WangXuan95/FPGA-FOC/(threads)

Thread 1 (2021-03-01):

求RTL文件下对应每个模块的modelsim仿真测试代码！

red1508, 2021-03-01:
作者您好！ 能加个联系方式吗？很紧急，需要modelsim仿真测试代码，请问您有仿真代码吗？谢谢！

red1508, 2021-03-01:
急需仿真测试代码！ 方便的话能加个联系方式吗？我微信： lpf360726

WangXuan95, 2021-03-01:
你好，我没有对该工程进行整体仿真，因为仿真法很难模拟出电机的行为。但是为了验证正确性，我分模块单独进行了一些仿真，一些复杂的模块我用 SystemVerilog 写了 testbench （我没有把testbench挂在github上），简单的模块我就没写 testbench ，因为能保证肯定没问题。你可以阅读每个模块的定义来自己写 testbench 进行验证（因为输入输出都不复杂，所以 testbench 写起来非常简单）。我已加你微信。

xiao162, 2021-05-20:
作者您好！想向你请教关于fpga控制电机方面的知识，可以加个微信吗，微信号18297670446

user855, 2021-05-31:
作者您好!我有个问题想问您，第一，相电流低压侧三电阻采样需要运放放大电流信号才能作为AD输入吧，但您的PCB图并没有运放放大，请问您是如何处理的？ 第二，三电阻采样您电流重构的那部分代码如何理解呢？为什么ia= ADCb + ADCc - 2*ADCa。方便的话可以加个联系方式嘛？微信号：ZYH336614215。期待您的回复！

Closed 2022-04-07.

Thread 2 (2021-05-31):

关于电机FOC控制的一些疑惑

user855, 2021-05-31:
作者您好!我有个问题想问您，第一，相电流低压侧三电阻采样需要运放放大电流信号才能作为AD输入吧，但您的PCB图并没有运放放大，请问您是如何处理的？ 第二，三电阻采样您电流重构的那部分代码如何理解呢？为什么ia= ADCb + ADCc - 2*ADCa。方便的话可以加个联系方式嘛？微信号：ZYH336614215。期待您的回复！

WangXuan95, 2021-06-02:
你好！

第一，[我的PCB](https://oshwhub.com/wangxuan/arduino-foc-shield)使用了一体化的三相无刷电机驱动芯片MP6540（U1），3相电流采样电阻和放大器是集成在里面的。请注意MP6540的 SOA, SOB, SOC 三个引脚，它们就是三相电流放大后的电流输出。

第二，说来话长，我们知道电机的相电流 ia, ib, ic 是双极性的（即有正有负的，分别代表流出电机和流入电机），但我们常用的ADC往往都是单极性的（即只能采样正电压）。那么，相电流采样-放大电路就必须考虑双极性到单极性的转换问题，工程上用的方法往往都是反向放大加偏置（包括MP6540内置采样-放大电路也是这种方案），它输出给ADC的电压遵循公式：
ADCa = -R * ia + Voff
ADCb = -R * ib + Voff
ADCc = -R * ic + Voff
其中 R 是放大系数（R>0，也叫跨阻放大系数，因为 R 的量纲和电阻一样），因为反向放大所以加了负号。Voff 是偏置电压，以此保证 ADCa, ADCb, ADCc 是单极性的。
另外又有基尔霍夫电流定律（KCL）：
ia + ib + ic = 0
联立以上公式，可以推出：
3 * Voff = ADCa + ADCb + ADCc
我们令 R = 1/(3*k) ，于是：
ia = (Voff - ADCa) / R
    = k * (3 * Voff - 3 * ADCa)
    = k * (ADCa + ADCb + ADCc - 3 * ADCa)
    = k * (ADCb + ADCc - 2*ADCa)

于是就有了你问的  ia= ADCb + ADCc - 2*ADCa

你肯定会问，系数k哪儿去了？这个我们并不在乎，因为整个FOC都是线性系统，通过调整PID参数，能跑就行，系数只在理论分析时有用。

WangXuan95, 2021-06-02:
你好！

第一，[我的PCB](https://oshwhub.com/wangxuan/arduino-foc-shield)使用了一体化的三相无刷电机驱动芯片MP6540（U1），3相电流采样电阻和放大器是集成在里面的。请注意MP6540的 SOA, SOB, SOC 三个引脚，它们就是三相电流放大后的电流输出。

第二，说来话长，我们知道电机的相电流 ia, ib, ic 是双极性的（即有正有负的，分别代表流出电机和流入电机），但我们常用的ADC往往都是单极性的（即只能采样正电压）。那么，相电流采样-放大电路就必须考虑双极性到单极性的转换问题，工程上用的方法往往都是反向放大加偏置（包括MP6540内置采样-放大电路也是这种方案），它输出给ADC的电压遵循公式：
ADCa = -R * ia + Voff
ADCb = -R * ib + Voff
ADCc = -R * ic + Voff
其中 R 是放大系数（R>0，也叫跨阻放大系数，因为 R 的量纲和电阻一样），因为反向放大所以加了负号。Voff 是偏置电压，以此保证 ADCa, ADCb, ADCc 是单极性的。
另外又有基尔霍夫电流定律（KCL）：
ia + ib + ic = 0
联立以上公式，可以推出：
3 * Voff = ADCa + ADCb + ADCc
我们令 R = 1/(3*k) ，于是：
ia = (Voff - ADCa) / R
    = k * (3 * Voff - 3 * ADCa)
    = k * (ADCa + ADCb + ADCc - 3 * ADCa)
    = k * (ADCb + ADCc - 2*ADCa)

于是就有了你问的  ia= ADCb + ADCc - 2*ADCa

你肯定会问，系数k哪儿去了？这个我们并不在乎，因为整个FOC都是线性系统，通过调整PID参数，能跑就行，系数只在理论分析时有用。

user855, 2021-06-04:
谢谢您的回复！但我仍还有一些问题想请教一下您。

 针对问题一，我对AD采样部分我还有部分疑惑，您用的AD7928只有一个T/H(采样保持器)，也就意味着这个AD一次只能保持一个通道的数据，也就是说当通道1 打开的时候采集A相的电流，然后采集完再打开通道2采集B相的电流，那么这并不是一个同步采集的过程，您是如何实现AD采样三相电流的同步输出的呢？

针对问题二，我想知道您的程序里是不是都没有在乎系数K，包括clake变换中得到的i_alpha和i_beta和ia、ib、ic也并没有满足严格的公式关系，您程序中得到的i_alpha和i_beta是理论值的2倍。这是不是也可以用调整PID参数的思想来解释？

问题三，您有没有推荐的verilog深入学习的书籍推荐，我看到您程序中的一些设计方法很好，很想深入系统的学习一下，不知道您有没有什么资料推荐？
期待您的回复^_^

WangXuan95, 2021-06-06:
**回答问题1**：
在电流采样问题上，FpOC 与大多数 FOC 方案相同，因为 MP6540 里的采样电阻在下桥臂，所以规定 SVPWM 在每个控制周期（约 55us，对应频率18kHz）内至少有一段时间里 3 相都是下通上闭，称为**采样窗口**。FOC的基础振幅（也就是 foc_top.sv 里的 **MAX_AMP** 参数）越大，**采样窗口**越短。当 **MAX_AMP**=9'd511 (最大值) 时，**采样窗口**长度就是 0 了。而默认的 **MAX_AMP**=9'd384 大概会让**采样窗口**长度为十几us。
**AD7928** 只有一个T/H，所以**采样窗口**内要做 3 次采样，这个过程是 **hold_detect.sv** 和 **adc_ad7928.sv** 共同控制的，**hold_detect.sv**负责在采样窗口开始时延迟一段时间（来让电流趋于稳定）后发出 **sn_adc** 信号脉冲，来告诉 **adc_ad7928.sv** 可以开始工作了（可以通过 foc_top.sv 里的 SAMPLE_DELAY 来调整该延迟）。然后 **adc_ad7928.sv** 内部就会自动串行地完成 3 个通道的采样，最后再同步提交3个采样结果（提交的同时产生 **o_en_adc** 信号脉冲）。注意**adc_ad7928.sv**是一个通用的 **AD7928** 控制器，每收到一个  **i_sn_adc** 信号脉冲，就进行一系列串行采样。其中采样多少次，每次采样哪一个通道，都可以通过 **adc_ad7928.sv** 里的 parameter 来配置。所有通道采样结束后，产生**o_en_adc**信号脉冲，同时同步提交所有通道的结果。
我把 **foc_top.sv** 用来连接 ADC控制器的接口（也就是sn_adc, en_adc, adc_a, adc_b, adc_c 这几个信号）设计成同步读入3通道数据，是出于**通用性**、**简约性**和**可移植性**的原则考虑，因为这样的同步读入接口是 ADC 的一种高度抽象，最容易让人理解其时序（即，**sn_adc**脉冲命令ADC控制器开始工作。**en_adc**指示ADC读取器结束工作，同时 adc_a, adc_b, adc_c 上产生结果）。如果用户用了其它 ADC 型号，只需按照这个时序的抽象来具象地编写 ADC 控制器即可，而 **foc_top.sv** 并不关心拟用的是1个串行的ADC还是3个并行的ADC，反正你都要给我同步提交。当然，用户必须自己算好 **hold_detect.sv** 的延时 + ADC 采样三个通道（也即 **sn_adc** 脉冲和 **en_adc** 脉冲的时间差） 是小于 **采样窗口** 的长度的。

WangXuan95, 2021-06-06:
**回答问题2**：
是的，我很多地方的代码也与理论公式的系数不同，比如 clark 变换公式本来是：
- Iα = Ia - Ib/2 - Ic/2
- Iβ = √3/2 * (Ib - Ic)

我多乘了个2：

- Iα = 2 * Ia - Ib - Ic
- Iβ = √3 * (Ib - Ic)

这是出于避免整数计算的截断导致的数据位丢失，比如 Ib/2 就会让 Ib 的最低 bit 丢失。不过实际上这种小误差丝毫不会影响控制质量。
这种系数问题可以通过 PID 调参来消除。

实际上如果是成熟的控制器，应该出个文档，简明地给出整个过程中所有的运算叠乘起来的系数 k，用户可能关心这个k，因为很多FOC实际上是用理论分析（也就是把电机参数代入电机方程）来整定 PID 参数的。我是搞FPGA的，控制方面是门外汉，做这个东西是为了玩，所以没出这个文档说明，而且我自己调电机时是试出来的 PID 参数（手动狗头）

WangXuan95, 2021-06-06:
**回答问题3**：除了学 Verilog 基础语法外，我就没看过书了，所以也给你推荐不来。很多我都是自己写着写着发现的，比如发现怎样分模块抽象度更高，复用性更好，那我以后都这么写。

不知道你是初学还是进阶，学基础语法你可以看书（这种书很多，就不用我推荐了吧），同时可以上 [HDLBits](https://hdlbits.01xz.net/wiki/Main_Page) 做题（这里面题都很基础），同时为了不脱离实际，还要自己写小东西，比如做串口、SPI等芯片的控制把芯片驱动起来，这样才能达到最好的入门效果。

进阶的话，实际上硬件设计和优化是有很多技巧和定式（比如握手、流水、双缓冲、分支预测、脉动阵列之类），这方面我好像真没看见过什么书或者有谁总结过，可能是我孤陋寡闻了，如果能搜到这类技巧的总结来看，是能事倍功半的。不过有一点我很确定——进阶是要靠多写的，比如写复杂接口（比如 AXI4，SDR-SDRAM，以太网，SDIO，CAN 等）；复杂算法（电机控制、图像处理等）；写个CPU也是很好的选择。

user855, 2021-06-08:
谢谢您的回复！ 您的指导让我受益匪浅。 原谅我又有新问题了。
问题1，您进行串行采样的时候不会出现这样的问题嘛，即第一个时钟周期采到的是A相的电流，第2个时钟周期采的是B相，第3个时钟周期采到的是C相，而我们知道相电流是正弦变化的，这三个时钟周期采的A B C 三相电流并不是同一时刻的相电流，因此这将产生误差，而时钟周期是很短的，是不是产生的误差几乎可以忽略不计呢？
问题2，我想知道您的时钟频率为什么选择36.864MHz？这个时钟频率是有什么特殊含义嘛？我如果选择FPGA的50MHz会出现什么问题呢？
问题3，您的控制频率= 时钟频率 / 2048，为什么控制频率 = 时钟频率 / 2048？ 我觉得控制频率和时钟频率应该是没有必然的联系的吧，时钟频率是FPGA的时钟频率，而控制频率是pwm的频率，一般是几十khz，所以您是根据控制频率来确定的时钟频率嘛？

WangXuan95, 2021-06-11:
回答问题1，首先指正一个不准确的地方， **AD7928** 的接口是 SPI （一种串行接口），其采样是多个时钟周期（而不是一个时钟周期）内完成的。因此三相的采样间隔是几十个时钟周期（具体数字我忘了，你可以仿真确定一下）。虽然并不同步，但3相的采样毕竟都是在同一个控制周期的采样窗口（几微秒）内，而相电流的变化通常以控制周期（即几十微秒）为尺度变化，想想3000r/min（50r/s）的转子，若极对数=7，其相电流也不过是350Hz（周期28ms）的正弦波，该正弦波在几微秒内的变化是可以忽略的。

回答问题2，其实选 36.864MHz，只是因为可以让控制周期为 36864/2048 = 18kHz，凑个整。
foc_top.sv 和 as5600_read.sv 对时钟频率是没有要求的，多高都可以（唯一的限制是频率太高时序不收敛）
但 adc_ad7928.sv 限制了频率不能大于 40.96MHz，因为 ADC7928 的 SPI 时钟不能超过 20.48MHz，而 adc_ad7928.sv 内部用驱动时钟2分频作为SPI时钟。
综上，时钟频率是可调的，但要小于 40.96MHz。

回答问题3， 理想地来讲，FPGA时钟频率和控制周期确实没有关系，但要考虑实际啊，PWM不也是FPGA的时钟驱动的？既然如此，必然有个分频系数（控制频率 = 时钟频率 / 分频系数），别的驱动器可能具有可调的分频系数，但FpOC里为了简单，分频系数=2048。这意味着 FpOC 如果要调节控制频率，就只能调时钟频率，目前受限于上述ADC7928的频率限制，最高的控制频率是 40.96MHz/2048=20kHz。

user855, 2021-06-16:
谢谢您的回答。您的指导让我受益匪浅^ ^  然而我又有新问题了...
问题一，我看您的pi那部分代码是位置式pi控制， 其计算的表达式是$$_u_k = K_p(e_k)+K_i\sum(e_k)_$$，根据计算公式，您代码中的参量kpidelta即应该为输出结果，您pi_controller.sv代码中的91-100行的always块中的  value <= protect_add(value, kpidelta); 这一步是什么原理？位置式的pi又为何要求每一步的增量呢？以及您的pi并未设置积分限幅和积分清零，是否有必要设置呢？

问题二，您代码中的cartesian2polar,sv是把电压矢量从转子直角坐标系 (Vd, Vq) 变换到转子极坐标系 (Vrρ, Vrθ)，我一直不理解我们为什么要变换到转子极坐标系中进行运算？是为了简化计算亦或是处于其他目的？

jjinl, 2024-06-18:
你好，求教一下，svpwm.sv中 查表，输入和输出是什么关系？  x2--> y3
always @ (posedge clk)
case(x2)
10'd0:y3<=9'd442;
10'd1:y3<=9'd443;

Closed 2022-03-23.

Thread 3 (2021-08-26):

关于pid_control有点点疑问

clarekee, 2021-08-26:
pid_control里的赋值语句
assign o_value = value[31:16];
这里为什么需要除以2的16次方哈？
第二个疑问：您积分项计算采用了之前所有时刻累积的误差，也就是采用绝对PID控制的公式，但是输出的结果加在了上一时刻的输出结果，也就是代码默认的是增量式PID，但是增量式PID采用的是近三个周期的误差即可，感觉有点前后矛盾。

Closed 2023-06-09.

Thread 6 (2022-09-04):

关于phi数值放缩请教的问题

chenmengqi52421314, 2022-09-04:
在ipark处理完输出导SVPWM的模块中会有一个角度的输出，我在使用您的程序尝试进行控制BLDC时，由于我的编码器是1000脉冲，因此在输出的电角度时，我采用您的公式  psi <= {4'h0, POLE_PAIR} * (phi   - init_phi );  无法将电机转动，但我发现电机已经转动了180度，此时我将 输出改为 psi <= {4'h0, POLE_PAIR} * ((phi   - init_phi) << 2 );  这时，电机便能转动起来了；我想请教下，输出到SVPWM的电角度是否需要进行放缩处理；
 同时，我希望能和前辈沟通下相关的FPGA控制的内容，这是我的微信13692354659，希望前辈方便的状况下能指点下。

zxy180427, 2023-08-15:
您好，我在进行电流环闭环调试时，PID部分遇到一些问题，首先我看您最新修改了PID的公式，我先按照您原程序进行测试，首先我将VQ等于0，让ID跟随目标值进行变换，只使用P项进行调节，遍历后，依然没有得到想要的曲线

Thread 9 (2023-08-15):

关于PID调参的一些问题

zxy180427, 2023-08-15:
您好，我在进行电流环闭环调试时，PID部分遇到一些问题，首先我看您最新修改了PID的公式，我先按照您原程序（将最终结果值累加）进行测试，首先我将VQ等于0，让ID跟随目标值进行变换，只使用P项进行调节，遍历P值后，依然没有得到想要的曲线，我自己也编写了一个增量式的程序，结果也不尽人意，希望得到一些指点。

zxy180427, 2023-08-16:
且在开环调试时，我给定vd和vq值，经过堵转得到的IQ值为负数，经过电机换相后，情况并没有改观，您遇到过这个情况吗？

Thread 13 (2024-05-02):

Application without an ADC

jadoro, 2024-05-02:
Hi,

thank you very much for this great project!
I've been reading your notes on a minimal demo setup, where you list the ADC as one of the mandatory components. Can your control algorithm also be used without an ADC if torque control is not required?

Thanks a lot in advance!

WangXuan95, 2025-01-13:
Hello, this code must use ADC. The motor control method without ADC you mentioned is not FOC, at least not typical FOC. It cannot achieve torque control and has low efficiency. For its implementation, you can refer to SimpleFOC of Arduino: https://simplefoc.com/

Closed 2025-01-13.

Thread 14 (2024-07-01):

SVPWM仿真出来的波形和您给的图不太一样

a593765797, 2024-07-01:
您好您好，我根据您的代码进行仿真出来的SVPWM马鞍波部分和您给的图不太一样，请问给出的SVPWM部分的代码是最终版本吗？主要是我也没太懂您SVPWM代码的逻辑，不太清楚该咋改。想请教您一下这部分的思路，可以方便加个联系方式么？我的微信是15603329173，万分感谢！

WangXuan95, 2025-01-13:
不太可能。是不是你没缩放到位。截图看看波形？
