WangXuan95/FPGA-FOC/RTL/foc/svpwm.v

//--------------------------------------------------------------------------------------------------------
// 模块：svpwm
// Type    : synthesizable
// Standard: Verilog 2001 (IEEE1364-2001)
// 功能：7 段式 SVPWM 生成器（调制器） 
// 输入：定子极坐标系下的电压矢量 Vsρ, Vsθ
// 输出：PWM使能信号 pwm_en
//       3相PWM信号 pwm_a, pwm_b, pwm_c
// 说明：该模块产生的 PWM 的频率是 clk 频率 / 2048。例如 clk 为 36.864MHz ，则 PWM 的频率为 36.864MHz / 2048 = 18kHz
//--------------------------------------------------------------------------------------------------------

module svpwm (
    input  wire        rstn,
    input  wire        clk,
    input  wire [ 8:0] v_amp,                       // svpwm 的最大电压矢量的幅值
    input  wire [11:0] v_rho,                       // 定子极坐标系下的电压矢量的幅值 Vsρ
    input  wire [11:0] v_theta,                     // 定子极坐标系下的电压矢量的角度 Vsθ
    output reg         pwm_en, pwm_a, pwm_b, pwm_c  // PWM使能信号 pwm_en, 3相PWM信号 pwm_a, pwm_b, pwm_c
);

localparam ROM_LATENCY = 11'd4;

reg  [10:0] cnt;
reg  [11:0] rom_x;
reg         rom_sy;
reg  [ 8:0] rom_y;
reg  [ 8:0] mul_i1;
reg  [11:0] mul_i2;
wire [20:0] mul_y = mul_i1 * mul_i2;
reg  [11:0] mul_o;
reg         sya, syb, syc;
reg  [ 8:0] ya, yb;
reg  [ 9:0] pwma_duty, pwmb_duty, pwmc_duty;
reg  [10:0] pwma_lb, pwma_ub, pwmb_lb, pwmb_ub, pwmc_lb, pwmc_ub;
reg         pwm_act;

always @ (posedge clk or negedge rstn)
    if(~rstn)
        mul_o <= 12'd0;
    else
        mul_o <= mul_y[20:9];

always @ (posedge clk or negedge rstn)
    if(~rstn)
        cnt <= 11'd0;
    else
        cnt <= cnt + 11'd1;

always @ (posedge clk or negedge rstn)
    if(~rstn) begin
        rom_x <= 0;
        mul_i1 <= 0;
        mul_i2 <= 0;
        {sya, syb, syc} <= 0;
        {ya, yb} <= 0;
        {pwma_duty, pwmb_duty, pwmc_duty} <= 0;
        {pwma_lb, pwma_ub, pwmb_lb, pwmb_ub, pwmc_lb, pwmc_ub} <= 0;
        pwm_act <= 1'b0;
    end else begin
        if(cnt==11'd2041-ROM_LATENCY) begin
            rom_x <= v_theta;
            mul_i1 <= v_amp;
            mul_i2 <= v_rho;
        end else if(cnt==11'd2042-ROM_LATENCY) begin
            rom_x <= rom_x - 12'd1365;
        end else if(cnt==11'd2043-ROM_LATENCY) begin
            rom_x <= rom_x - 12'd1365;
            mul_i2 <= mul_o + 12'd8;
        end else if(cnt==11'd2042) begin
            mul_i1 <= rom_y;
            sya <= rom_sy;
        end else if(cnt==11'd2043) begin
            mul_i1 <= rom_y;
            syb <= rom_sy;
        end else if(cnt==11'd2044) begin
            mul_i1 <= rom_y;
            syc <= rom_sy;
            ya <= mul_o[11:3];
        end else if(cnt==11'd2045) begin
            yb <= mul_o[11:3];
        end else if(cnt==11'd2046) begin
            pwma_duty <= sya ? 10'd512-{1'b0, ya        } : 10'd512+{1'b0, ya        };
            pwmb_duty <= syb ? 10'd512-{1'b0, yb        } : 10'd512+{1'b0, yb        };
            pwmc_duty <= syc ? 10'd512-{1'b0,mul_o[11:3]} : 10'd512+{1'b0,mul_o[11:3]};
        end else if(cnt==11'd2047) begin
            pwma_lb <= 11'd0 + {1'b0, pwma_duty};
            pwma_ub <= 11'd0 - {1'b0, pwma_duty};
            pwmb_lb <= 11'd0 + {1'b0, pwmb_duty};
            pwmb_ub <= 11'd0 - {1'b0, pwmb_duty};
            pwmc_lb <= 11'd0 + {1'b0, pwmc_duty};
            pwmc_ub <= 11'd0 - {1'b0, pwmc_duty};
            pwm_act <= 1'b1;
        end
    end

always @ (posedge clk or negedge rstn)
    if(~rstn) begin
        pwm_en <= 1'b0;
        pwm_a <= 1'b1;
        pwm_b <= 1'b1;
        pwm_c <= 1'b1;
    end else begin
        pwm_en <= pwm_act;
        pwm_a <= ~pwm_act || cnt<=pwma_lb || cnt>pwma_ub;
        pwm_b <= ~pwm_act || cnt<=pwmb_lb || cnt>pwmb_ub;
        pwm_c <= ~pwm_act || cnt<=pwmc_lb || cnt>pwmc_ub;
    end



reg [11:0] x1;
reg [ 9:0] x2;
reg        s2;
reg        z2;
reg [ 8:0] y3;
reg        s3;
reg        z3;

always @ (posedge clk)
    if(rom_x >= 12'd2048)
        x1 <= 12'd0 - rom_x;
    else
        x1 <= rom_x;

always @ (posedge clk) begin
    z2 <= x1 == 12'd1024;
    if( x1 <= 12'd1024 ) begin
        x2 <= x1[9:0];
        s2 <= 1'b0;
    end else begin
        x2 <= 10'd0 - x1[9:0];
        s2 <= 1'b1;
    end
end

always @ (posedge clk) begin
    z3 <= z2;
    s3 <= s2;
end

always @ (posedge clk) begin
    rom_sy <= s3;
    if(z3)
        rom_y <= 9'd0;
    else
        rom_y <= y3;
end

always @ (posedge clk)
case(x2)
10'd0:y3<=9'd442;
10'd1:y3<=9'd443;
10'd2:y3<=9'd443;
10'd3:y3<=9'd444;
10'd4:y3<=9'd444;
10'd5:y3<=9'd444;
10'd6:y3<=9'd445;
10'd7:y3<=9'd445;
10'd8:y3<=9'd446;
10'd9:y3<=9'd446;
10'd10:y3<=9'd446;
10'd11:y3<=9'd447;
10'd12:y3<=9'd447;
10'd13:y3<=9'd447;
10'd14:y3<=9'd448;
10'd15:y3<=9'd448;
10'd16:y3<=9'd449;
10'd17:y3<=9'd449;
10'd18:y3<=9'd449;
10'd19:y3<=9'd450;
10'd20:y3<=9'd450;
10'd21:y3<=9'd450;
10'd22:y3<=9'd451;
10'd23:y3<=9'd451;
10'd24:y3<=9'd452;
10'd25:y3<=9'd452;
10'd26:y3<=9'd452;
10'd27:y3<=9'd453;
10'd28:y3<=9'd453;
10'd29:y3<=9'd453;
10'd30:y3<=9'd454;
10'd31:y3<=9'd454;
10'd32:y3<=9'd454;
10'd33:y3<=9'd455;
10'd34:y3<=9'd455;
10'd35:y3<=9'd456;
10'd36:y3<=9'd456;
10'd37:y3<=9'd456;
10'd38:y3<=9'd457;
10'd39:y3<=9'd457;
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
endcase

endmodule
