WangXuan95/FPGA-FOC/RTL/foc/cartesian2polar.v

//--------------------------------------------------------------------------------------------------------
// 模块： cartesian2polar
// Type    : synthesizable
// Standard: Verilog 2001 (IEEE1364-2001)
// 功能： 把直角坐标系 (x,y) 转换为极坐标系 
//--------------------------------------------------------------------------------------------------------

module cartesian2polar #(
    parameter ATTENUAION = 0
) (
    input  wire               rstn,
    input  wire               clk,
    input  wire               i_en,
    input  wire signed [15:0] i_x, i_y,
    output reg                o_en,
    output reg         [11:0] o_rho,
    output reg         [11:0] o_theta
);

reg [ 4:0] cnt;
reg        signx, signy, signxy;
reg [15:0] absx, absy;  // 0~32768
reg [27:0] smtb, smta;
reg [27:0] accb;
reg [15:0] acca;

reg [8:0] rom_a, rom_theta;
reg [8:0] a;
reg [11:0] theta;
reg [15:0] amp;

wire [23:0] mul = {15'd0,a} * {8'd0,absx};

wire [15:0] amp_w = {2'b0,mul[23:10]} + absx;
wire [15:0] ampatt_w = amp_w >> ATTENUAION;

always @ (posedge clk or negedge rstn)
    if(~rstn) begin
        cnt <= 0;
        {signx, signy, signxy, absx, absy, smtb, smta, accb, acca} <= 0;
        {a, theta, amp} <= 0;
        {o_en, o_rho, o_theta} <= 0;
    end else begin
        o_en <= 1'b0;
        if(cnt==5'd0) begin
            accb <= 0;
            acca <= 0;
            signx <= (i_x < $signed(16'd0));
            signy <= (i_y < $signed(16'd0));
            absx  <= (i_x < $signed(16'd0)) ? -i_x : i_x;
            absy  <= (i_y < $signed(16'd0)) ? -i_y : i_y;
            if(i_en)
                cnt <= 5'd30;
        end else begin
            cnt <= cnt - 5'd1;
            if(cnt>=5'd30) begin
                signxy <= absx < absy;
                if(absx < absy) begin
                    absx <= absy;
                    smtb <= {absy, 12'h0};
                    smta <= {absx, 12'h0};
                end else begin
                    smtb <= {absx, 12'h0};
                    smta <= {absy, 12'h0};
                end
            end else if(cnt>5'd4) begin
                if( accb + smtb <= 28'h8000 ) begin
                    accb <= accb + smtb;
                    acca <= acca + smta[15:0];
                end
                smtb <= smtb >> 1;
                smta <= smta >> 1;
            end else if(cnt==5'd4) begin
                a <= acca[15] ? 9'd424 : rom_a;
                theta <= (acca[15:3]>=13'd4090) ? 12'd512 : {3'b0,rom_theta};
            end else if(cnt==5'd3) begin
                if(signxy) begin
                    theta <= 12'd1024 - theta;
                end
            end else if(cnt==5'd2) begin
                amp <= ampatt_w;
                if(signx)
                    theta <= 12'd2048 - theta;
            end else if(cnt==5'd1) begin
                o_en <= 1'b1;
                o_rho <= amp>16'd4095 ? 12'd4095 : amp[11:0];
                o_theta <= signy ? 12'd0-theta : theta;
            end
        end
    end

always @ (posedge clk)
case(acca[14:3])
12'd0:{rom_a,rom_theta}<={9'd0,9'd0};
12'd1:{rom_a,rom_theta}<={9'd0,9'd0};
12'd2:{rom_a,rom_theta}<={9'd0,9'd0};
12'd3:{rom_a,rom_theta}<={9'd0,9'd0};
12'd4:{rom_a,rom_theta}<={9'd0,9'd1};
12'd5:{rom_a,rom_theta}<={9'd0,9'd1};
12'd6:{rom_a,rom_theta}<={9'd0,9'd1};
12'd7:{rom_a,rom_theta}<={9'd0,9'd1};
12'd8:{rom_a,rom_theta}<={9'd0,9'd1};
12'd9:{rom_a,rom_theta}<={9'd0,9'd1};
12'd10:{rom_a,rom_theta}<={9'd0,9'd2};
12'd11:{rom_a,rom_theta}<={9'd0,9'd2};
12'd12:{rom_a,rom_theta}<={9'd0,9'd2};
12'd13:{rom_a,rom_theta}<={9'd0,9'd2};
12'd14:{rom_a,rom_theta}<={9'd0,9'd2};
12'd15:{rom_a,rom_theta}<={9'd0,9'd2};
12'd16:{rom_a,rom_theta}<={9'd0,9'd3};
12'd17:{rom_a,rom_theta}<={9'd0,9'd3};
12'd18:{rom_a,rom_theta}<={9'd0,9'd3};
12'd19:{rom_a,rom_theta}<={9'd0,9'd3};
12'd20:{rom_a,rom_theta}<={9'd0,9'd3};
12'd21:{rom_a,rom_theta}<={9'd0,9'd3};
12'd22:{rom_a,rom_theta}<={9'd0,9'd4};
12'd23:{rom_a,rom_theta}<={9'd0,9'd4};
12'd24:{rom_a,rom_theta}<={9'd0,9'd4};
12'd25:{rom_a,rom_theta}<={9'd0,9'd4};
12'd26:{rom_a,rom_theta}<={9'd0,9'd4};
12'd27:{rom_a,rom_theta}<={9'd0,9'd4};
12'd28:{rom_a,rom_theta}<={9'd0,9'd4};
12'd29:{rom_a,rom_theta}<={9'd0,9'd5};
12'd30:{rom_a,rom_theta}<={9'd0,9'd5};
12'd31:{rom_a,rom_theta}<={9'd0,9'd5};
12'd32:{rom_a,rom_theta}<={9'd0,9'd5};
12'd33:{rom_a,rom_theta}<={9'd0,9'd5};
12'd34:{rom_a,rom_theta}<={9'd0,9'd5};
12'd35:{rom_a,rom_theta}<={9'd0,9'd6};
12'd36:{rom_a,rom_theta}<={9'd0,9'd6};
12'd37:{rom_a,rom_theta}<={9'd0,9'd6};
12'd38:{rom_a,rom_theta}<={9'd0,9'd6};
12'd39:{rom_a,rom_theta}<={9'd0,9'd6};
12'd40:{rom_a,rom_theta}<={9'd0,9'd6};
12'd41:{rom_a,rom_theta}<={9'd0,9'd7};
12'd42:{rom_a,rom_theta}<={9'd0,9'd7};
12'd43:{rom_a,rom_theta}<={9'd0,9'd7};
12'd44:{rom_a,rom_theta}<={9'd0,9'd7};
12'd45:{rom_a,rom_theta}<={9'd0,9'd7};
12'd46:{rom_a,rom_theta}<={9'd0,9'd7};
12'd47:{rom_a,rom_theta}<={9'd0,9'd7};
12'd48:{rom_a,rom_theta}<={9'd0,9'd8};
12'd49:{rom_a,rom_theta}<={9'd0,9'd8};
12'd50:{rom_a,rom_theta}<={9'd0,9'd8};
12'd51:{rom_a,rom_theta}<={9'd0,9'd8};
12'd52:{rom_a,rom_theta}<={9'd0,9'd8};
12'd53:{rom_a,rom_theta}<={9'd0,9'd8};
12'd54:{rom_a,rom_theta}<={9'd0,9'd9};
12'd55:{rom_a,rom_theta}<={9'd0,9'd9};
12'd56:{rom_a,rom_theta}<={9'd0,9'd9};
12'd57:{rom_a,rom_theta}<={9'd0,9'd9};
12'd58:{rom_a,rom_theta}<={9'd0,9'd9};
12'd59:{rom_a,rom_theta}<={9'd0,9'd9};
12'd60:{rom_a,rom_theta}<={9'd0,9'd10};
12'd61:{rom_a,rom_theta}<={9'd0,9'd10};
12'd62:{rom_a,rom_theta}<={9'd0,9'd10};
12'd63:{rom_a,rom_theta}<={9'd0,9'd10};
12'd64:{rom_a,rom_theta}<={9'd0,9'd10};
12'd65:{rom_a,rom_theta}<={9'd0,9'd10};
12'd66:{rom_a,rom_theta}<={9'd0,9'd11};
12'd67:{rom_a,rom_theta}<={9'd0,9'd11};
12'd68:{rom_a,rom_theta}<={9'd0,9'd11};
12'd69:{rom_a,rom_theta}<={9'd0,9'd11};
12'd70:{rom_a,rom_theta}<={9'd0,9'd11};
12'd71:{rom_a,rom_theta}<={9'd0,9'd11};
12'd72:{rom_a,rom_theta}<={9'd0,9'd11};
12'd73:{rom_a,rom_theta}<={9'd0,9'd12};
12'd74:{rom_a,rom_theta}<={9'd0,9'd12};
12'd75:{rom_a,rom_theta}<={9'd0,9'd12};
12'd76:{rom_a,rom_theta}<={9'd0,9'd12};
12'd77:{rom_a,rom_theta}<={9'd0,9'd12};
12'd78:{rom_a,rom_theta}<={9'd0,9'd12};
12'd79:{rom_a,rom_theta}<={9'd0,9'd13};
12'd80:{rom_a,rom_theta}<={9'd0,9'd13};
12'd81:{rom_a,rom_theta}<={9'd0,9'd13};
12'd82:{rom_a,rom_theta}<={9'd0,9'd13};
12'd83:{rom_a,rom_theta}<={9'd0,9'd13};
12'd84:{rom_a,rom_theta}<={9'd0,9'd13};
12'd85:{rom_a,rom_theta}<={9'd0,9'd14};
12'd86:{rom_a,rom_theta}<={9'd0,9'd14};
12'd87:{rom_a,rom_theta}<={9'd0,9'd14};
12'd88:{rom_a,rom_theta}<={9'd0,9'd14};
12'd89:{rom_a,rom_theta}<={9'd0,9'd14};
12'd90:{rom_a,rom_theta}<={9'd0,9'd14};
12'd91:{rom_a,rom_theta}<={9'd0,9'd14};
12'd92:{rom_a,rom_theta}<={9'd0,9'd15};
12'd93:{rom_a,rom_theta}<={9'd0,9'd15};
12'd94:{rom_a,rom_theta}<={9'd0,9'd15};
12'd95:{rom_a,rom_theta}<={9'd0,9'd15};
12'd96:{rom_a,rom_theta}<={9'd0,9'd15};
12'd97:{rom_a,rom_theta}<={9'd0,9'd15};
12'd98:{rom_a,rom_theta}<={9'd0,9'd16};
12'd99:{rom_a,rom_theta}<={9'd0,9'd16};
12'd100:{rom_a,rom_theta}<={9'd0,9'd16};
12'd101:{rom_a,rom_theta}<={9'd0,9'd16};
12'd102:{rom_a,rom_theta}<={9'd0,9'd16};
12'd103:{rom_a,rom_theta}<={9'd0,9'd16};
12'd104:{rom_a,rom_theta}<={9'd0,9'd17};
12'd105:{rom_a,rom_theta}<={9'd0,9'd17};
12'd106:{rom_a,rom_theta}<={9'd0,9'd17};
12'd107:{rom_a,rom_theta}<={9'd0,9'd17};
12'd108:{rom_a,rom_theta}<={9'd0,9'd17};
12'd109:{rom_a,rom_theta}<={9'd0,9'd17};
12'd110:{rom_a,rom_theta}<={9'd0,9'd18};
12'd111:{rom_a,rom_theta}<={9'd0,9'd18};
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
12'd2669:{rom_a,rom_theta}<={9'd198,9'd376};
12'd2670:{rom_a,rom_theta}<={9'd198,9'd377};
12'd2671:{rom_a,rom_theta}<={9'd198,9'd377};
12'd2672:{rom_a,rom_theta}<={9'd199,9'd377};
12'd2673:{rom_a,rom_theta}<={9'd199,9'd377};
12'd2674:{rom_a,rom_theta}<={9'd199,9'd377};
12'd2675:{rom_a,rom_theta}<={9'd199,9'd377};
12'd2676:{rom_a,rom_theta}<={9'd199,9'd377};
12'd2677:{rom_a,rom_theta}<={9'd199,9'd377};
12'd2678:{rom_a,rom_theta}<={9'd199,9'd377};
12'd2679:{rom_a,rom_theta}<={9'd200,9'd378};
12'd2680:{rom_a,rom_theta}<={9'd200,9'd378};
12'd2681:{rom_a,rom_theta}<={9'd200,9'd378};
12'd2682:{rom_a,rom_theta}<={9'd200,9'd378};
12'd2683:{rom_a,rom_theta}<={9'd200,9'd378};
12'd2684:{rom_a,rom_theta}<={9'd200,9'd378};
12'd2685:{rom_a,rom_theta}<={9'd200,9'd378};
12'd2686:{rom_a,rom_theta}<={9'd201,9'd378};
12'd2687:{rom_a,rom_theta}<={9'd201,9'd378};
12'd2688:{rom_a,rom_theta}<={9'd201,9'd379};
12'd2689:{rom_a,rom_theta}<={9'd201,9'd379};
12'd2690:{rom_a,rom_theta}<={9'd201,9'd379};
12'd2691:{rom_a,rom_theta}<={9'd201,9'd379};
12'd2692:{rom_a,rom_theta}<={9'd201,9'd379};
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
