WangXuan95/FPGA-FOC/RTL/foc/sincos.v

//--------------------------------------------------------------------------------------------------------
// 模块：sincos 
// Type    : synthesizable
// Standard: Verilog 2001 (IEEE1364-2001)
// 功能： 计算 sin 和 cos
//        在 i_theta 上给出角度（0~π被映射为0~4095），
//        在 o_sin 和 o_cos 上产生 sinθ 和 cosθ （-1~+1 被映射为 -16384~+16384）
//--------------------------------------------------------------------------------------------------------

module sincos(
    input  wire               rstn,
    input  wire               clk,
    input  wire               i_en,
    input  wire        [11:0] i_theta,      // a round is mapped to 0~4095
    output reg                o_en,
    output reg  signed [15:0] o_sin, o_cos  // -1~+1 is mapped to -16384~+16384
);


localparam [2:0] IDLE = 3'd0,
                 S1   = 3'd1,
                 S2   = 3'd2,
                 S3   = 3'd3,
                 S4   = 3'd4,
                 S5   = 3'd5;

reg [ 2:0] stat;

reg [11:0] theta_a, theta_b;
reg        cos_z, cos_s, sin_z, sin_s;
reg [ 9:0] rom_x;
reg [14:0] rom_y;
reg signed [15:0] cos_tmp;

always @ (posedge clk or negedge rstn)
    if(~rstn) begin
        stat <= IDLE;
        {theta_a, theta_b} <= 0;
        {cos_z, cos_s, sin_z, sin_s} <= 0;
        rom_x <= 0;
        cos_tmp <= 0;
        {o_en, o_sin, o_cos} <= 0;
    end else begin
        o_en <= 1'b0;
        case(stat)
            IDLE: if(i_en) begin
                stat <= S1;
                theta_a <= i_theta - 12'd1024;
                if(i_theta>12'd2048)
                    theta_b <= 12'd0 - i_theta;
                else
                    theta_b <= i_theta;
            end
            S1: begin
                stat <= S2;
                if(theta_a>12'd2048)
                    theta_b <= 12'd0 - theta_a;
                else
                    theta_b <= theta_a;
                if(theta_b>12'd1024) begin
                    rom_x <= 10'd0 - theta_b[9:0];
                    cos_z <= 1'b0;
                    cos_s <= 1'b1;
                end else begin
                    rom_x <= theta_b[9:0];
                    cos_z <= theta_b==12'd1024;
                    cos_s <= 1'b0;
                end
            end
            S2: begin
                stat <= S3;
                if(theta_b>12'd1024) begin
                    rom_x <= 10'd0 - theta_b[9:0];
                    sin_z <= 1'b0;
                    sin_s <= 1'b1;
                end else begin
                    rom_x <= theta_b[9:0];
                    sin_z <= theta_b==12'd1024;
                    sin_s <= 1'b0;
                end
            end
            S3: begin
                stat <= S4;
                if(cos_z)
                    cos_tmp <= 0;
                else if(cos_s)
                    cos_tmp <= -$signed({1'b0,rom_y});
                else
                    cos_tmp <=  $signed({1'b0,rom_y});
            end
            S4: begin
                stat <= S5;
                o_en <= 1'b1;
                o_cos <= cos_tmp;
                if(sin_z)
                    o_sin <= 0;
                else if(sin_s)
                    o_sin <= -$signed({1'b0,rom_y});
                else
                    o_sin <= $signed({1'b0,rom_y});
            end
            default: // S5:
                stat <= IDLE;
        endcase
    end

always @ (posedge clk)
case(rom_x)
10'd0:rom_y<=15'd16384;
10'd1:rom_y<=15'd16384;
10'd2:rom_y<=15'd16384;
10'd3:rom_y<=15'd16384;
10'd4:rom_y<=15'd16384;
10'd5:rom_y<=15'd16384;
10'd6:rom_y<=15'd16383;
10'd7:rom_y<=15'd16383;
10'd8:rom_y<=15'd16383;
10'd9:rom_y<=15'd16382;
10'd10:rom_y<=15'd16382;
10'd11:rom_y<=15'd16382;
10'd12:rom_y<=15'd16381;
10'd13:rom_y<=15'd16381;
10'd14:rom_y<=15'd16380;
10'd15:rom_y<=15'd16380;
10'd16:rom_y<=15'd16379;
10'd17:rom_y<=15'd16378;
10'd18:rom_y<=15'd16378;
10'd19:rom_y<=15'd16377;
10'd20:rom_y<=15'd16376;
10'd21:rom_y<=15'd16375;
10'd22:rom_y<=15'd16375;
10'd23:rom_y<=15'd16374;
10'd24:rom_y<=15'd16373;
10'd25:rom_y<=15'd16372;
10'd26:rom_y<=15'd16371;
10'd27:rom_y<=15'd16370;
10'd28:rom_y<=15'd16369;
10'd29:rom_y<=15'd16368;
10'd30:rom_y<=15'd16367;
10'd31:rom_y<=15'd16365;
10'd32:rom_y<=15'd16364;
10'd33:rom_y<=15'd16363;
10'd34:rom_y<=15'd16362;
10'd35:rom_y<=15'd16360;
10'd36:rom_y<=15'd16359;
10'd37:rom_y<=15'd16358;
10'd38:rom_y<=15'd16356;
10'd39:rom_y<=15'd16355;
10'd40:rom_y<=15'd16353;
10'd41:rom_y<=15'd16352;
10'd42:rom_y<=15'd16350;
10'd43:rom_y<=15'd16348;
10'd44:rom_y<=15'd16347;
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
10'd1013:rom_y<=15'd276;
10'd1014:rom_y<=15'd251;
10'd1015:rom_y<=15'd226;
10'd1016:rom_y<=15'd201;
10'd1017:rom_y<=15'd176;
10'd1018:rom_y<=15'd151;
10'd1019:rom_y<=15'd126;
10'd1020:rom_y<=15'd101;
10'd1021:rom_y<=15'd75;
10'd1022:rom_y<=15'd50;
10'd1023:rom_y<=15'd25;
endcase
endmodule
